chroco/einstein_robot/Documentation/Einstien Servo Information.pdf

Body Part Grouping | Movement Name | Servo Number | Maximum Range | Minimum Range
Eye Group | Eyes_Horizontal | 0 | 0 | 180
| Eyes Vertical | 1 | 0 | 150
| Eye_Right | A0 | LOW | HIGH
| Eye_Left | A1 | LOW | HIGH
Brow Group | Brow Right | 2 | 0 | 180
| Brow Left | 3 | 0 | 180
Jaw Group | Jaw Right | 4 | 0 | 180
| Jaw Left | 5 | 0 | 180
Head Group | Head Turn | 6 | 0 | 180
| Head Tilt | 7
Right Arm Group | Arm Right Shoulder | 8 | 20 | 180
| Arm Right Rotate | 9 | 90 | 125
| Arm Right Elbow | 10 | 10 | 170
