chroco/einstein_robot/(commit log)

2017-11-27 all servos accounted for
2017-11-27 Test for the base DC motors
2017-11-27 added DC motor stuff, needs testing
2017-11-29 servos tested
2017-12-05 servo wrapper, reorganized code
2017-12-07 added servo_control
2017-12-09 Basic servo information
    PDF has information about the servos connections, groupings, maximum value and minimum value.
